JoemanJ/Falando-Por-AI/Componentes.md

# Componentes

## **Módulo Microfone com Amplificador MAX9814**
**Descrição:**
*   Módulo microfone com pré-amplificador

**Datasheet:**
*   [https://www.alldatasheet.com/datasheet-pdf/download/217128/MAXIM/MAX9814.html](https://www.alldatasheet.com/datasheet-pdf/download/217128/MAXIM/MAX9814.html)

**Links de Referência:**
*   Link de compra: [https://www.makerhero.com/produto/modulo-microfone-com-amplificador-max9814/](https://www.makerhero.com/produto/modulo-microfone-com-amplificador-max9814/)
*   Tutorial : [https://www.phippselectronics.com/using-the-max9814-microphone-amplifier-module-with-arduino/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](https://www.phippselectronics.com/using-the-max9814-microphone-amplifier-module-with-arduino/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)
*   Tutorial: [https://youtu.be/52ddjXRiiHY?si=9vU9T2BaqhUVWsFL](https://youtu.be/52ddjXRiiHY?si=9vU9T2BaqhUVWsFL)

**Especificações Técnicas:**
*   Tensão de alimentação: 2,7V - 5,5V
*   Tensão de saída: 0,25V - 2,25
## Placa STM32F401CEU6 (STM32 Blackpill)
**Descrição:**
*   Placa de desenvolvimento com microcontrolador STM32 integrado.

**Datasheet:**
*   Datasheet DO PROCESSADOR: [https://www.st.com/en/microcontrollers-microprocessors/stm32f411ce.html](https://www.st.com/en/microcontrollers-microprocessors/stm32f411ce.html)
*   Datasheet DA PLACA: [https://stm32-base.org/boards/STM32F411CEU6-WeAct-Black-Pill-V2.0.html](https://stm32-base.org/boards/STM32F411CEU6-WeAct-Black-Pill-V2.0.html)

**Links de Referência:**
*   Tutorial inicial sobre STM32: [https://youtube.com/playlist?list=PLNyfXcjhOAwO5HNTKpZPsqBhelLF2rWQx&si=seHv-gioDRl3KWVt](https://youtube.com/playlist?list=PLNyfXcjhOAwO5HNTKpZPsqBhelLF2rWQx&si=seHv-gioDRl3KWVt)
*   Tutoriais gerais sobre STM32: [https://www.youtube.com/@stm32world](https://www.youtube.com/@stm32world)
*   Tutoriais de DSP com STM32: [https://www.youtube.com/@PhilsLab](https://www.youtube.com/@PhilsLab)

**Especificações Técnicas:**
*   Tensão de alimentação: 5V
*   Tensão de saída: 3,3V
*   Escala de tensão do ADC: 0V - 3,3V
*   Corrente máxima de saída: 300mA

**Observações:**
*   Pode ser alimentado por um pino de 5V ou por 5V na porta USB-C, MAS NUNCA OS DOIS AO MESMO TEMPO!
## Conversor DAC PCM5102A
**Descrição:**
*   Módulo conversor digital-analógico com compatível com comunicação I2S e saída P2

**Datasheet:**
*   [https://www.alldatasheet.com/datasheet-pdf/pdf/788993/TI1/PCM5102A.html](https://www.alldatasheet.com/datasheet-pdf/pdf/788993/TI1/PCM5102A.html) (datasheet do chip)
*   [https://macsbug.wordpress.com/?s=DAC+module](https://macsbug.wordpress.com/?s=DAC+module) (blog em japonês falando do MÓDULO DAC)

**Modelo 3D:**
*   [https://grabcad.com/library/pcm5102-dac-audio-modul-1](https://grabcad.com/library/pcm5102-dac-audio-modul-1)

**Links de Referência:**
*   Tutorial: [https://youtu.be/1T9PKLeBDFc?si=V\_gMjMPcOXJFr1zo](https://youtu.be/1T9PKLeBDFc?si=V_gMjMPcOXJFr1zo)
*   Tutorial: [https://www.instructables.com/Raspberry-Pi-HQ-Audio-PCM5102-and-MPD/](https://www.instructables.com/Raspberry-Pi-HQ-Audio-PCM5102-and-MPD/)

**Especificações Técnicas:**
*   Tensão de alimentação: 2,5 - 5V
*   Potência de saída: 3W + 3W (3W para cada canal de áudio)
*   Corrente máxima de saída: 3A
*   Compatibilidade: Speakers de 4Ohm e 8Ohm
