JoemanJ/Falando-Por-AI/Falando por AI.ioc

Mcu.UserName=STM32F411CEUx
PA1.Signal=ADCx_IN1
PB1.Signal=GPXTI1
PB12.Signal=I2S2_WS
PB13.Signal=I2S2_CK
PB15.Signal=I2S2_SD
PB3.Signal=GPIO_Output
PB4.Signal=GPIO_Output
PB5.Signal=GPIO_Output
PB6.Signal=GPIO_Output
PB7.Signal=GPIO_Output
PB8.Signal=GPIO_Output
PB9.Signal=GPIO_Output
PC13-ANTI_TAMP.GPIO_Label=LED
PC13-ANTI_TAMP.Signal=GPIO_Output
