JoemanJ/Falando-Por-AI/(commit log)

2025-07-24 Coisas que funcionam
2025-07-27 filters first implementation
2025-07-28 need to fix DAC
    [audio_processing.c, audio_processing.h]
2025-07-29 improved sample frequency maching (TIM2 counts up to 334)
2025-08-07 added pitch shifters
2025-08-31 Document audio processing filters and effects
    Add detailed explanations and code examples for low-pass filter, high-pass filter, distortion, and echo effects.
2025-08-31 o que é (README.md)
2025-08-31 use single button on pin B1
2025-08-31 Update README with filter implementation and AI details
2025-08-31 Update README with detailed filter implementation info
    Expand explanation of voice filters and AI application challenges.
